ECESeniorDesign/greenhouse_envmgmt/hardware/sensor_module_1_0_render.png

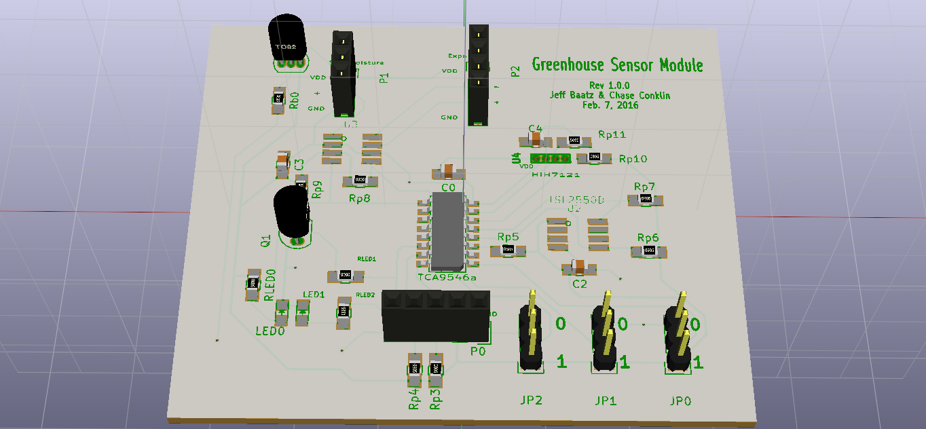
hardware/sensor_module_1_0_render.png
