ECESeniorDesign/greenhouse_envmgmt/hardware/sensor_module_render.png

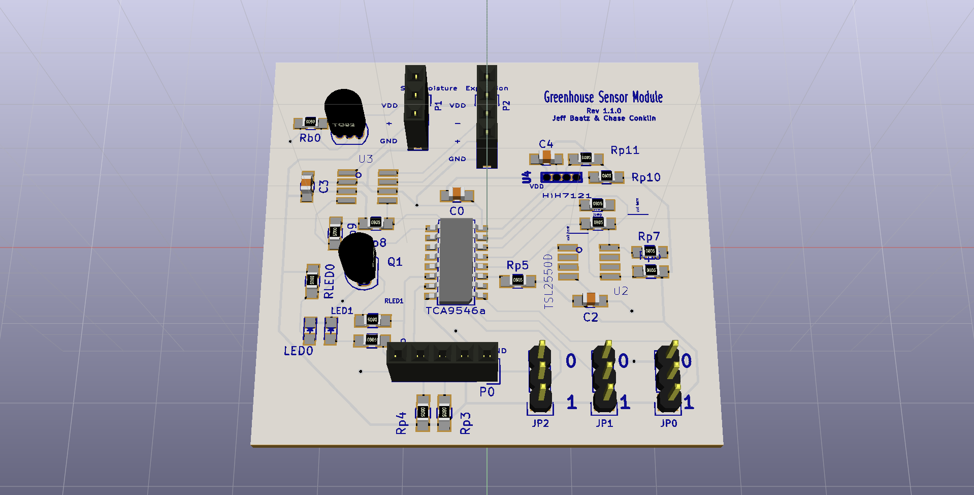
hardware/sensor_module_render.png
