ECESeniorDesign/greenhouse_envmgmt/README.rst

===========
Greenhouse Environment Manager
===========

This package contains models for interacting with the greenhouse sensor and control modules used for an automated tabletop greenhouse.

The README will be expanded as development continues, including detailed API usage.
