ECESeniorDesign/greenhouse_envmgmt/(list of files, cad)

Other CAD files:
hardware/model_GH.prt
