ECESeniorDesign/greenhouse_envmgmt/(threads)

Thread 1 (2015-12-11):

Create Development Sensor Modules

jeffrobots, 2015-12-11:
SMT sensor components should be mounted on a surfboard with easy to use pinouts for simple development.
This issue has been opened as a progress tracking mechanism.

jeffrobots, 2015-12-11:
Temperature and light sensors have been mounted and at least some of them have been verified to work. Closing issue.

Closed 2015-12-11.

Thread 2 (2015-12-11):

Test sensor modules for connectivity

jeffrobots, 2015-12-11:
- [x] Connect I2C modules to raspberry pi
- [x] Configure circuit according to datasheet.
        * http://pdf1.alldatasheet.com/datasheet-pdf/view/211808/STMICROELECTRONICS/STLM75M2E.html

- [x] Verify that the modules are working correctly by determining if they can be detected.
- [x] This should be repeated for all sensor modules after initial construction
   - [x] Temperature sensors
   - [x] Light sensors
   - [x] Humidity Sensors

Issue opened for progress tracking

jeffrobots, 2015-12-11:
The above steps have been verified for the temperature modules. The light sensor modules still need to be tested.

In order to test, the temperature modules were connected according to the datasheet listed above. Then, after enabling I2C on the raspberry pi, running sudo i2cdetect -y 1 pings all I2C devices and prints the addresses in the terminal.

Closed 2016-01-26.

Thread 3 (2015-12-13):

Light sensor modules do not support multiple address modes

jeffrobots, 2015-12-13:
The light sensors currently used in this project, the TSL2550D, are hard wired to a single address.

Why? No idea. Makes no sense.

Anyway, I need to figure out whether we can get by with just one lux sensor or if a method by which two can be used is possible. The final alternative would be going back to square one and getting a new lux sensor.

One possible solution here is to multiplex the SDA line. This would allow us to stretch out the single address by consuming one or two GPIO pins on the raspberry pi. This should be relatively easy. The only possible issue is I2C clock stretching that I can see, but it seems unlikely that this will actually cause an issue.

jeffrobots, 2015-12-13:
Possible target for I2C multiplexing:
http://www.digikey.com/product-detail/en/TCA9543ADR/296-42064-2-ND/5246239

Another solution could be using GPIO and a FET to physically power lux sensors down completely.

jeffrobots, 2015-12-19:
The I2C multiplexer is ordered and mounted. I will test as soon as I get a chance.

jeffrobots, 2015-12-20:
I may be holding off on this for a while. In attempting to solder on the breakout pins to the surfboard modules, I accidentally burned out one of the chips because my soldering iron just isn't small enough to avoid heating the board. Rather than risk burning out the other I2C multiplexer or an ADC, I may just wait until I have access to a better soldering iron.

jeffrobots, 2016-01-10:
Finally got the i2c multiplexer up and running. It turns out the issue that I was having was a lack of a pull-up to VCC on the active low reset line, causing the module to hold in a reset state and not respond to detects.

I can now begin using the i2c multiplexer to add in multiple light sensors and - if I decide to reorder them - humidity sensors as well.

jeffrobots, 2016-01-17:
Closing as per commit 13c06d7a230f20efa5b15ccbbee2ae22d221d495

Aside from a lack of pullup resisters that are required to make the system reliable, everything appears to be working well in breadboard test/verification.

Closed 2016-01-17.

Thread 4 (2015-12-19):

Humidity sensor needs SPI implementation

jeffrobots, 2015-12-19:
In a rush to get things ordered, I accidentally ordered a couple of HIH7131 sensors in the SPI variant instead of the I2C variant.

Since they're kind of expensive, I'm going to implement some code to acquire humidity data over SPI to make sure the sensors are going to fit the project requirement.

At some point, I will need to re-order the I2C modules so that I can use the I2C switching modules to get around the lack of switchable addresses in the HIH module.

[The datasheet can be found here.](http://sensing.honeywell.com/honeywell-sensing-humidicon-hih7000-series-product-sheet-009074-6-en.pdf)

jeffrobots, 2016-01-20:
This issue is now obsolete, as new I2C humidity sensors have been ordered.

Closed 2016-01-20.

Thread 5 (2015-12-19):

Fertilizer and Water Quality Levels

jeffrobots, 2015-12-19:
After doing some research into various methods for determining soil characteristics such as fertilizer and pH levels, it seems like it's going to be a lot easier to measure pH OR conductivity of our water reservoir, as this can be done using a probe in the water bucket whereas measuring soil quality is generally done by taking soil samples and diluting them with a known solution - it's not exactly practical at this point with our budget.

Note that I say OR above because getting a reliable sensor can be pretty expensive for either method.

#### pH
Measuring pH can be done with a glass probe and an interface circuit containing a gain stage, filtering, and potentially temperature compensation. BNC connected probes of varying quality can be had on Amazon for less than 30 dollars. This one seems like a no brainer: I even found a resource [here](http://www.eecs.ucf.edu/seniordesign/sp2014su2014/g09/documents/Group-9-Senior-Design-1-LeafAlone-Hydroponics.pdf) that may have some useful information on how to interface to one of these things. It looks like this project got a lot of it's info from Atlas Scientific, so I'll check that out to see what they have to offer.

#### Conductivity
A similar thing with conductivity can be done using a toroidal non-contact conductivity sensor. The
5000TC Toroidal Conductivity Sensor is an example of this. I'm having a hard time finding prices, but they look to be somewhere around $80-$100 dollars a piece. The downside here is that while conductivity might give us a guess as to nutrient levels (assuming we WANT to use water based fertilizers), it really just measures everything, so it's going to end up being dependent on whatever the water supply is. High chlorine levels would essentially look the same as high fertilizer levels, for example.

cconklin, 2015-12-19:
I wonder how the Flower Power was able to do it so easily?

jeffrobots, 2015-12-19:
In short... I don't think it was. I think what they did is use a cheap electrode to measure conductivity of the soil and then they just called it good. I have a feeling that the sensor on the Flower Power more or less amounted to a really crude, rough guess as to the soil condition.

Even having air pockets in the soil would throw off a simple electrode like that - the measurement would be highly dependent on water content.

cconklin, 2015-12-19:
I guess my feeling is a crude guess about the soil condition is better than an accurate understanding of the water condition (since the plants won't be in the reservoir water). Ignoring air pockets, would it be possible to combine soil moisture settings and conductivity to control for the effect of water? I would be happy to help with the constructing of a model for that once we get back from break.

Also, since pH is determined mostly by a chemical rather than electrical process, I say we go with conductivity.

jeffrobots, 2015-12-19:
I suppose it's possible to control for moisture effects. I've not been able to find any off the shelf soil conductivity sensors though. The DIY type stuff seems kind of ghetto and not very elegant, but perhaps we could come up with something.

What do you mean by chemical rather than electrical process? You can measure pH with an electrode probe. Here are a few references. [How-To guide using probes and a simple interface](http://www.allaboutcircuits.com/textbook/direct-current/chpt-9/ph-measurement/) | [Example of such a probe on Amazon](http://www.amazon.com/dp/B001EHJO64?psc=1)

Conversely, Here's an example of a conductivity meter [from Amazon](http://www.amazon.com/Sper-Scientific-Conductivity-Benchtop-Salinity/dp/B00BEZX6Z6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)

If we want to create an in-soil conductivity meter, we're probably going to have to make it ourselves.

cconklin, 2015-12-19:
I stand corrected.

cconklin, 2015-12-19:
Could we get something like [this](http://www.amazon.com/Luster-Leaf-1880-Rapitest-Electronic/dp/B000HHLJQA) and use an ADC to get our readings (since we aren't using many of our GPIO pins)?

jeffrobots, 2015-12-19:
That's certainly an interesting idea. My main concern there would be reverse engineering it and getting useful data from it. It's a slightly less elegant approach, but it could work. I find it really odd that just the probes themselves cost more than these all-in-one units. Perhaps I'm focusing too much on making the solution elegant and one-of-a-kind.

For the soil moisture level, [we can use these.](https://www.sparkfun.com/products/13322)

The ADC isn't an issue. I have three 4ch I2C ADCs mounted on some surfboards already. We've got plenty of power to go around there even without touching more GPIO.

jeffrobots, 2015-12-19:
According to the reviews on the types of meters, meters like this apparently corrode over time and become inaccurate. Something to think about I suppose. There probably isn't a way around that other than finding a way to clean them or just replacing them. If you think it's a good route forward, I can order a few to be here after break and we can hack a few of them apart. My plan was to try and figure out the soil moisture stuff over break along with how to solve the issue I've created with the humidity sensors in issue #4. Oops...

cconklin, 2015-12-20:
I think it is an interesting way to go forward. Let's do some research into what's out there for those, and try to have a list of candidates in the next week. If we like any of the options, we can order a couple and hack them apart.

jeffrobots, 2015-12-20:
If we want to do just pH, [we could use this one](http://amzn.com/B0000DI848) which is probably the cheapest bet. It's $25 for a 6 pack. It's a great blend of super cheap and replaceable and *allegedly* accurate readings.

For fertility, we could use the one you linked or [this one](http://amzn.com/B006JFY9ZW)

cconklin, 2015-12-20:
Let's get the pH meter you linked. While the one I found could measure more things, I don't think it could do it all at once, and developing the circuitry to switch between modes would be tricky.

jeffrobots, 2016-01-04:
I decided to hold off on ordering the stuff until I get back to school since I haven't been able to work with the interface modules that much. Fortunately, I just got a new soldering station with a hot air gun and SMT tips, so hopefully I can repair my earlier screwup and get everything else assembled.

jeffrobots, 2016-01-19:
After reading some literature and reviews, it seems that the lifetime of an anode/cathode type sensor like a pH sensor or soil moisture sensor can be extended significantly by keeping them powered off when you aren't using them. This would be easy to accomplish with a single MOSFET.

Closed 2016-02-03.

Thread 6 (2016-01-15):

Integrate sensors with webservice

jeffrobots, 2016-01-15:
[See issue 1 on Webservice Demo for more info](https://github.com/ECESeniorDesign/greenhouse-webservice-demo/issues/1)

Need to create an interface for linking webservice to the available sensor hardware.

My current idea is to create a model of a sensor cluster that contains information on current values and addresses for the various sensors.

cconklin, 2016-01-15:
As I see it, you intend to have a class that knows all about getting sensor information. That should work: all you would need to do would be to add a method of knowing which plant the sensors are for, and a `saveAllSensors` method that does the following:

```python
def saveAllSensors(self):
    # Assuming that you imported models
    plant = models.Plant.for_slot(self.plantId)
    # Save light data
    plant.sensor_data_points.light().build(sensor_value=self.lux).save()
    # More saving here...
```

jeffrobots, 2016-01-15:
The latest commit hopefully is doing what you're talking about. Aside from the greenhouse demo not having a space for a temperature record, this is hopefully ready to go into an implementation that can be used to demo.

I still need to tie in the I2C multiplexer and get the ADC/acidity/soil moisture stuff figured out. I also need to fix the humidity sensor situation. Aside from these glaring, very important issues, having this interface somewhat fleshed out is going to make tying these other modules in a bit more clearcut.

jeffrobots, 2016-01-15:
I forgot to add that the method for determining which sensor belongs to which plant is pretty much going to be to hardcode it in at the time of SensorCluster object instantiation. I could add a dictionary that would make it easier to read, but at the end of the day the addresses will still need to be hardcoded.

cconklin, 2016-01-15:
I just added temperature. You can look at the diff at ECESeniorDesign/greenhouse-webservice-demo@a101052 to see how to add more (if you need to).

cconklin, 2016-01-15:
Make sure that you also open a database connection and that you `import models` from the greenhouse webservice when you do it for real.

jeffrobots, 2016-01-23:
As per our test yesterday, I'm going to close this issue just to clear up the panel. However, since my code isn't currently interfacing outside of the tests to verify that it will work, you should be sure to get documentation up so that I can wrap all of that into the relevant scripts when the time comes to do so.

Closed 2016-01-23.

Thread 7 (2016-01-20):

Add support for UART

jeffrobots, 2016-01-20:
In order to use only one ADC module for the entire project, I have opted to use an extremely cost effective four channel ADC. Unfortunately, this threw my plan of having everything on I2C out the window - the I2C variant of the module is out of stock. So I ordered the UART one at a measly two dollars a chip. [The datasheet can be found here](http://www.silabs.com/Support%20Documents/TechnicalDocs/Si8900-1-2.pdf)

As such, support for UART in python is needed. I've been looking around at different packages. pySerial seems to be fairly promising [as shown here](https://electrosome.com/uart-raspberry-pi-python/)

It looks pretty straightforward to use once past the initial boot file configuration, so I'll get going on installing it and testing it in the next couple of days.

jeffrobots, 2016-01-23:
Obsolete.

Closed 2016-01-23.

Thread 8 (2016-01-21):

Design PCB for sensor modules

jeffrobots, 2016-01-21:
KiCad will be used to develop sensor module PCB files as soon as the prototype circuits are proven. The packages will use the smallest sensor packages possible. They should also include necessary pull-up resistors and bypass capacitors. The datasheets contain layout information (as well as connection information) and should be referenced often.

Required:
- [x] Proof the sensor module prototype in its entirety.
- [x] Move design to schematic and PCB Gerber file
- [x] Implement status LEDs and analog sensor power control
- [x] Design review of PCB layout

Recommended:
- [x] Move sensor prototype to a soldered perfboard and proof again
- [x] Order and test received PCBs

jeffrobots, 2016-01-24:
@cconklin In case you're interested, 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.

Even if you're not interested, I think I should go over the schematics with someone in the department before I send them off for fabrication. That's a little ways away though. I still need to get some new components in just to verify everything. I also need to figure out if any sort of interface/amplification will be needed on our pH and soil moisture meters.

cconklin, 2016-01-24:
Agreed. We can discuss it further with Derefinko on Monday.

jeffrobots, 2016-02-08:
The last required tasks before the PCB can be ordered are verifying the BJT soil sensor power control as well as looking into adding status LEDs where appropriate.

jeffrobots, 2016-02-10:
As of 6536d1a24c97237ee98df545fb8141bdaf6287d7 I have confirmed that using a transistor to power the soil sensor on and off will work.

I will be reworking the PCB files tomorrow to include this and a status LED.

jeffrobots, 2016-02-13:
@cconklin I just uploaded the gerbers to OSHPark. I'll figure out how to order through the department on monday.

If you want to see it, take a look here.

<a href="https://oshpark.com/shared_projects/Xo4KOmY4">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</a>

jeffrobots, 2016-03-03:
@cconklin

Everything works perfectly on the board except for, as you might be able to guess, the light sensor.

The status LED isn't working, and I thought it was an issue of the resistor size. After closer inspection, it seems possible that I actually wired it up backwards. They don't really have very visible markings for determining which way to put it and I wasn't really thinking straight when I was soldering it.

Are you free at all tomorrow afternoon in case I need a second pair of eyes on the light sensor? I've looked it over a bit and honestly have no idea what its problem is.

cconklin, 2016-03-03:
I probably won't be available.

jeffrobots, 2016-03-03:
After testing continuity on the pads of the light sensor, I discovered that the SMBus pads on the light sensor are indeed swapped. Luckily, @cconklin convinced me to put jumper pads so that I can switch them around if need be. I grabbed a few jumpers from the lab and will stick them on the board and cut the traces as soon as possible.

jeffrobots, 2016-03-03:
Closing as per today's testing.

Remaining issues regarding the sensor PCB will be design enhancements and should have their own issues.

Closed 2016-03-03.

Thread 10 (2016-01-23):

Automatically detect new sensor clusters

jeffrobots, 2016-01-23:
This is a low priority improvement that would make it much easier for a user to add new sensor clusters and to modify existing sensor cluster layouts.

A potential process for doing this would be to:
- Prompt the user to unplug all but one sensor module.
- Send out iterative commands to all of the detected I2C devices.
     - The commands will be unique such that - for example - only the temperature module will respond to a `detectTemperatureSensor()` command.
- Collect addresses, sensor type, and cluster ID for each sensor. There should be 4 addresses total.
     - Store this data in a CSV file.
- Prompt the user to unplug that sensor module and plug in another one.
- Repeat the processes, appending the new addressing information to the CSV.

When initializing the plant sensor structures in the python code, accessing this CSV will provide all of the necessary information. The process may also be able to warn the user of conflicting addresses.

Closed 2016-02-14.

Thread 11 (2016-01-23):

Implement Controls Interface

jeffrobots, 2016-01-23:
An interface by which python calls can be made to turn on the mist pump, grow lamps, and a ventilation fan is needed.

- [x] Set up GPIO package on raspberry pi
- [x] Create control model interface
- [x] Test/verify physical operation
    - This can be seen in the controltest.py script.
- [ ] Implement on-off logic based on an ideal and a current humidity/soil moisture
- [ ] Implement fan vent for a state where current humidity is too high
- [ ] Implement grow lamp on-off for when light levels are too low (should also be checking time of day)

jeffrobots, 2016-02-21:
The remaining tasks on this list are obsolete, as they will be handled in a separate python module.

Closing issue. Remaining controls tasks are related to updates to the controls API and hardware related tasks.

Closed 2016-02-21.

Thread 13 (2016-02-10):

Develop more simple API for sensors and Controls

jeffrobots, 2016-02-10:
- [x] Sensor modules
- [x] Controls

Each module should have a simple way to control all of its attributes. For the sensors, this means that updating sensors should be able to be done (but not required to be done) with one or two function calls.

For controls, this means that the user should be able to turn on and off individual control units on request with one or two function calls AND that the user should be able to specify a list of units that need to be turned on.

jeffrobots, 2016-02-21:
@cconklin

Could you look over the classes for the sensors and controls to see if the API is workable (or if you have suggestions on cleaning it up).

For sensors, you can mostly look at update_all_sensors(), update_instance_sensors(), and save_instance_sensors(). Note that update_all_sensors and update_instance_sensors() contain an optional argument for updating the soil moisture sensors instead since we may not want to constantly powering them up. Having the option to only update them on the hour - for example - will extend their lifetime significantly.

For controls, you can mostly look at control() and get_water_level().

These are really the only methods I would see you interacting with unless you want to do specific sensor updates or anything weird that I haven't thought of.

cconklin, 2016-02-21:
@jeffrobots

**Controls**

1. From an API standpoint, it doesn't make much sense to have `get_water_level` (a *sensor* method) to be present on a control interface. It looks like you put it here because the water tank sensor is connected to the control board.

2. How does the `bus` parameter change? I noticed in the control test file that you always set `bus = smbus.SMBus(1)`. Is this specific to the test you are running, or is this a universal constant. If the value is more of a constant (or isn't likely to vary / has a reasonable default), I would recommend making it part of the ControlCluster object (i.e. set to an instance variable during initialization) and having a default value.

**Sensors**

See point 2 above. Other than that, the API looks pretty good.

jeffrobots, 2016-02-21:
1) Good point. I originally put it there in case we wanted the pump operation to ask if it can turn on by sensing water level each time. This is now obsolete, since the pump can ping the database instead. My other reason being that it will be using a separate adc that sits on the controls.

2) The bus object is static, but it's global to the entire system. I hadn't thought to hide instances within sensor and control objects, but that would definitely clean up some of the methods so long as the smbus API supports that.

3) Ehh. I don't plan on using one now since we have the mist pump. It's more or less a feature that some users would want in the future, so I saw no reason to pull it out. I'm not that attached to it though.

cconklin, 2016-02-21:
Also, if a control cluster with ID 3 or 4 tries to turn off the pump, it looks like nothing will happen, since it won't send the update to the correct bank.

jeffrobots, 2016-02-21:
I'm not sure I follow your last point. The pump pin and bank are pulled from the controls class and are hard-coded to bank 0 pin 0. The pump requests list is dynamically sized and accessed by instance IDs. I'll take a look at it this afternoon to double check.

cconklin, 2016-02-21:
When you call `update`, it sends the mask for the bank to the bus. Since the pump bank is hardcoded to 0, when a control with ID 3 or 4 (bank 1) is updated, the pump will see no change. Is there something I am missing?

jeffrobots, 2016-02-21:
Ahh. Good catch. That's a simple patch. I'll put it in the API update to reflect your points this afternoon.

Closed 2016-02-22.

Thread 14 (2016-02-10):

Determine maximum cabling length for sensor nodes

jeffrobots, 2016-02-10:
The I2C Bus protocol allows for a maximum of 400pF of bus capacitance at 100kHz. Going above this - or even approaching it - will likely introduce communication errors. Luckily once the I2C data arrives at the sensor head, (the TCA9546a multiplexer) there is a rebroadcast of the signal and any additional capacitance is negligible. Furthermore, using small pull-up resistors decreases the capacitive time constant of the bus, yielding some additional wiggle room.

| Source of Capacitance | Capacitance Contribution | Maximum Contribution Allowed |
| ----------------------------- | -------------------------------- | -------------------------------------- |
| TCA9546 Mux               | 4.6 pF                               | 8 x 4.6pF (36.8 pF)                  |
| Ribbon Cable (13751-E)| 47.5pF/m or 26.7pF/m     | 7m * 47.5pf (332.5 pF)             |
| PN2222A (LED driver) |  25 pF max                         | 25 pF

If we want to go beyond this or not use ribbon cable (IE, use single core or threaded wire) we should be looking into cat5 or cat6 wire.

For the purpose of only using two sensors as in our prototype, it's going to be fairly negligable at 1m or so (which is about what we expect.)

Some more research and some lab tests should be done to verify that higher quality cable will not be needed for the initial prototype.

jeffrobots, 2016-04-12:
Issue is obsolete. Closing.

Closed 2016-04-12.

Thread 15 (2016-02-11):

Investigate light sensor failure

jeffrobots, 2016-02-11:
The light sensor TSL2550D is occasionally failing to update and the SMBus object is throwing an IOError exception.

It seems to be intermittent, and running the sensortest script repeatedly yields fairly mixed results.

So far, I haven't been able to successfully determine why this could be happening. I didn't start to see the issue until recently, so it's possible that it's caused by bus capacitance. Interestingly enough, this is the only module using the SMBus subprotocol. This could be a good thing to investigate, as the I2C multiplexer likely has settings that could compensate for any differences.

In the mean time, adding a retry method would be a quick but dangerous fix.

jeffrobots, 2016-02-11:
Immediately after I made this issue, I started removing things that I've added to the prototype in the last couple of days. The problem went away almost immediately after removing the BJT being used to control the I2C status LED. It looks as though the extra capacitance or load that this places on the bus is enough to completely kill the SMBus light sensor. Adding a larger resistor to the base of the BJT LED driver fixes the issue (I went from 1.8k and 2k and experienced no issues whatsoever), but I'm not very confident that the issue won't spring up later on.

Looking at the datasheet, the light sensor operates at a maximum frequency of 100kHz, which is the same bus speed that the Raspberry Pi defaults to. It could be that SMBus is more susceptable to bus capacitance for whatever reason, because I can't see any reason that the bus speed would be limited like that.

Closed 2016-02-20.

Thread 17 (2016-02-22):

Create Controls Prototype Circuitry

jeffrobots, 2016-02-22:
The control devices are currently modeled as simple LEDs in order to observe on/off capabilities. In order to control real devices, the LED/resistor circuitry needs to switch a BJT and thus turn on a relay. The controls circuitry has the following requirements.

Research areas:
- [x] Voltage/Power regulation
    - Needs 5V, 12V, and 24V.
    - The grow lamps will likely need 120AC.
    - Powering the raspberry pi through this same 5V would be ideal.
        - The best solution for this seems to be powering the pi through USB and having the pi supply the 5V to the rest of the circuitry that needs it (which is mostly ICs)
        - Make sure the analog sensors won't draw too much current in this case.
            - Using a supply that can give at least 700mA would likely be safe. RPi uses ~500mA
            - I've been using a laptop USB port, which theoretically only provides 500mA and have had no issues.

- [x] The IO pins need to be connected to the relays through a transistor.
    - Pin A0 will belong to the water pump.
    - Pin A1 will belong to the power switch for the analog sensors.
    - Other pin mappings can be found in the control model within ControlCluster
        - Ideally, the protoboard should be laid out so that these pins can be switched.

- [x] ADC for water tank level sensing
    - There needs to be an ADC mounted to the protoboard and hooked into the I2C bus.
        - Set address to 0x6c to avoid conflicts with SensorCluster ADCs
    - Use the 14SOIC ADC. It's overkill, but has a lot of address selection and could support other environment sensors later on.

Tasks:
- [x] Create schematic

- [x] Build breadboard prototype.
    - Can test with the fans and mini water pump if need be.
    - Make it at least somewhat re-configurable (using jumpers, perhaps)

- [ ] Order in lights

- [x] Connect actual control devices to the board

- [x] Mount on more permanent protoboard.

jeffrobots, 2016-02-23:
Created a prototype schematic shown below (using circuitlab)
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

My intention for the time being is to expose the inputs to each FET-Relay circuit to a jumper so that they can easily be swapped around by simply plugging them into the jumper in a different order.

The power supplies aren't really laid out at all on the schematic. This is because I haven't decided how I'll do it yet. I've been looking into buck converters that I could use to generate the 12V needed to power the fans that would be driven from the 24V pump supply. This same 24V supply will also provide the coil voltage needed to power the relays.

The lights are another story. They'll need to be powered off of 120AC. I can get away with one plug for all of the lights pretty easily provided I design their circuitry safe enough.

jeffrobots, 2016-02-24:
Per task 2:

The schematic above seems to work pretty well for making it easy to swap control devices around. It's just a matter of directing the VDD wire of the device to the proper voltage source for that device and connect the other to one of the relays. Other than that change, nothing is really needed to switch devices around. Also, since they're all relays, it doesn't really matter if say the pump is moved to another spot. This is the main benefit of a relay array - You can drive whatever you want on them and so long as the current doesn't exceed 5A, it will work.

jeffrobots, 2016-02-26:
Per research areas:

A buck converter will be used to generate the 12V needed to drive the fans and the 24V supply will be the same supply that's driving the pump - albeit with some circuit protection added in. The raspberry pi will be powered from a standard phone charger. The lights will be powered from a standard 110VAC outlet. This means that in total, three plugs will be used by the greenhouse. All power will be routed to a surge protector mounted to the greenhouse.

jeffrobots, 2016-03-22:
Creating a new issue to deal with more specific tasks regarding this issue.

The controls prototype functions correctly and has been mostly migrated to a perfboard solution. This perfboard solution needs to be finished and tested. It also needs to be fit into the control box.

Closed 2016-03-22.

Thread 18 (2016-02-24):

Can we instantiate multiple SMBus objects?

cconklin, 2016-02-24:
I'm working on the controls service on the web server, and I realized that I will need to have the controls establish a connection to the SMBus, which in production will occur at the same time as the sensor program (which also has a connection to the bus) is running. Will this cause a problem?

jeffrobots, 2016-02-25:
I ran a few tests to see how the SMBus class will handle multiple bus objects. It doesn't appear that you're going to run into any issues using multiple bus objects. I haven't tried anything with mutex/locks which I know you will be using, so I can't really make any guarantees there, but I suspect there's no issue either way.

Just make sure you always instantiate it as such:

```python
SensorCluster.bus = smbus.SMBus(1)
ControlCluster.bus = smbus.SMBus(1)
```

cconklin, 2016-02-25:
Thanks for looking into it.

jeffrobots, 2016-02-25:
@cconklin

I wanted to note that the SMBus objects have a close() and open() method. I've not used them a whole lot, but it appears that close() acts like a sort of pseudo-destroyer for a bus object. I say pseudo because while it does indeed disconnect the object from the I2C bus, it doesn't look like the open() method actually works right. Once you close it, reconnecting the object doesn't make it work again.

If this is functionality that you need, you'll need to play around with it to see if it will actually work properly.

Closed 2016-02-25.

Thread 19 (2016-02-26):

Making code available to web service

cconklin, 2016-02-26:
We are going to need a portable and simple way to ensure that the web service has access to the sensor and control code in this repository. I'm thinking that we could package this up and put it in PyPi so it is a simple "pip install" to get the necessary behavior anywhere.

Information about putting code on PyPi can be found [here](http://peterdowns.com/posts/first-time-with-pypi.html).

cconklin, 2016-02-26:
I can make the necessary changes, though it will result in a slight restructuring of the repository.

jeffrobots, 2016-02-26:
If you want to make the changes, I'm fine with that. I'm sure it would take me a day or two to get it figured out and ready for PyPi, since I'm not familiar with it. I'm assuming you will need to hide or remove the hardware aspect of the repo?

Either way, I'll look over the information you linked so that I at least know what's going on and can contribute.

jeffrobots, 2016-02-27:
I think I follow what needs to happen.

Basically, sensor_models and control_models need to put placed in their own directories, and then a new directory called "utils" would also need to be created to handle the utility functions that I've added. Each directory gets it's own `__init__.py`, the repo gets a new README, and then I tag for release. It doesn't sound too hard if you prefer I try and take care of it.

jeffrobots, 2016-02-27:
@cconklin

Greenhouse environment management (`greenhouse_envmgmt`) has been added to PyPi at release tag v1.0 with 146f08a082325edbb9c3235b110431809f9555db

After doing the pip install to test it out, I realized I'm going to need to clean up import dependencies. Think you could help out with that?

cconklin, 2016-02-27:
I can help with that.

cconklin, 2016-02-27:
It looks like your setup.py is bugged. There is a syntax error, and my pip can't find the python-smbus module.

```
Complete output from command python setup.py egg_info:
Traceback (most recent call last):
  File "<string>", line 1, in <module>
  File "/var/folders/jh/vszcshj577lcb234jny1fjkr0000gn/T/pip-wCAMGt-build/setup.py", line 10
     keywords = ['i2c', 'sensors', 'controls'],
            ^
SyntaxError: invalid syntax
```

Fixing the syntax error, I get:

```
Collecting python-smbus (from greenhouse-envmgmt==1.0)
  Could not find a version that satisfies the requirement python-smbus (from greenhouse-envmgmt==1.0) (from versions: )
No matching distribution found for python-smbus (from greenhouse-envmgmt==1.0)
```

jeffrobots, 2016-02-27:
I forgot to update setup.py with the one I used to register and upload with PyPi.

I removed install-requires completely in this version, but if you'd like to include it, the package is just smbus.

Sorry for the confusion.

cconklin, 2016-02-27:
Are you still having trouble with import dependencies?

jeffrobots, 2016-02-27:
The issue is more than - in order to use anything from the greenhouse-webservice, it needs to be added to the pack. It's more irritating than code-breaking. There are also probably packages being imported multiple times. It's something that can be cleaned up at a later date I believe.

jeffrobots, 2016-04-12:
Closing. The PyPi package will need to be updated once the sensors are calibrated, but is currently available.

Closed 2016-04-12.

Thread 21 (2016-03-03):

Revise PCB files to fix TSL2550 Footprint

jeffrobots, 2016-03-03:
The footprint and schematic file for the TSL2550D light sensor do not match up. This resulted in the pins for the clock and the data being swapped with one another. The PCB currently has pads for jumping the lines and cutting the old trace in order to switch them, but the kicad PCB files should be updated to have the error fixed by default.

jeffrobots, 2016-03-22:
Moved to low priority - Complete after other issues.

Thread 23 (2016-03-22):

Production controls circuitry and enclusure

jeffrobots, 2016-03-22:
The controls perfboards need to be finished and added to the control box.

Putting together the rest of the controls circuitry is dependent on the enclosure and cable management that will be used.

Tasks:
- [x] Determine cable routing and plug placement
- [x] Arrange and mount remaining controls hardware
- [x] Mount hardware and cabling inside enclosure with the raspberry pi

cconklin, 2016-03-22:
See this [micro-usb connector for the Pi](http://www.amazon.com/gp/product/B00OK6G036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). We will also need a 12V to 5V [buck converter](http://www.amazon.com/Nextrox®-Display-Supply-Converter-Module/dp/B00CBCGAL8/ref=pd_sim_23_2?ie=UTF8&dpID=410nEQxN-pL&dpSrc=sims&preST=_AC_UL160_SR160%2C160_&refRID=197WC55HT3SFKKTYTAV1).

jeffrobots, 2016-03-23:
As per recent work:

The controls circuitry has been mounted on a perfboard as the final solution. I have yet to verify that everything works after a few recent changes on the control board. The relay board appears to be working properly.

The next step is to mount everything inside the box enclosure. The placement of the plugs has been determined and we should be able to start routing the connection and cable paths in and out of the box soon.

A small pack of buck converter boards has also been ordered along with a 24V power supply. This will allow us to shrink the amount of external plugs down to one. The raspberry pi will be powered internally from a 5V buck converter.

jeffrobots, 2016-03-25:
@cconklin

I've just finished putting together the production controls circuitry and I've verified that it's working well.

Last Monday we talked about what software changes we would need to make in order to move to a 3-relay hardware solution and you mentioned me not needing to change anything on my side (aside from the pin mapping, I suppose).

Is this still the case? I was thinking of migrating all of the pin maps such that each control object is exposed to the same pin for the fan and the light respectively. They're already tied to the same pump, so no worries there.

Currently, a control module is exposed to 3 seperate pins (the valve is currently still included and needs removed). If your plan is to use one control module, then we won't need to change any structure and I'll just need to remap the pins to the correct ones to play with the current hardware. If you still wanted the control modules to be seperate, then I'll need to make more extensive changes.

For my reference, we will want the pump on the A1 relay, the fans in parallel on the A2 relay, and the lights in parallel on the A3 relay. The power toggle line for the soil sensors will be on A0 under the sensor model.

cconklin, 2016-03-25:
@jeffrobots

> Is this still the case?

Yes. I only have the web service interact with one control module (ID 1).

jeffrobots, 2016-04-12:
Work pertaining to this issue was completed at the end of last week on April 8th

Closed 2016-04-12.

Thread 24 (2016-03-30):

Install and mount environment hardware

jeffrobots, 2016-03-30:
The following components need to be mounted or installed to the greenhouse box.

- [x] Greenhouse sensor PCBs
    * These need to be coated in acetate first.
    * Three PCBs should be populated with one as a backup.
    * Custom cabling will need to be created. This should be measured.

- [x] Greenhouse controls box
    * See issue #23 for specifics.
    * Box should be mounted on the back or side of the greenhouse.

- [x] Pump/Fans/Lights
    * The pump will need a water reservoir to draw from, preferably mounted beside or behind the greenhouse.
        * The tank level sensor will need to run through the controls box and to the reservoir.
        * A 1" diameter tube is needed to house the level sensor.
    * Fans need to be bolted to the sides of the greenhouse.
    * Lights should be mounted on the top of the box and cabling should run so that the box can open

jeffrobots, 2016-03-30:
@cconklin

My goal is to try very, very hard to have all of this done by Friday of next week so that we can begin integration and test. I'm not sure how close I'll be to that deadline, but I may need a bit of help mounting some of the hardware to the greenhouse.

As soon as everything is installed, I'll want to get the web service/application running and integrated by the end of the following week, which is April 15th, so that we have almost two full weeks to debug. The sooner the better, but this is the latest these tasks should be done in my mind.

Let me know if you have anything blocking you currently in terms of getting the web service and application running on the Pi.

cconklin, 2016-03-30:
Currently nothing blocking me. I will try to get the web service running on the Pi by this Friday.

cconklin, 2016-04-01:
@jeffrobots

Web service installed on the pi and runs correctly. I've looked into getting it to start automatically, and that shouldn't be any real issue.

cconklin, 2016-04-03:
I have the autostart for the pi working. I can get it set up on yours sometime this week.

jeffrobots, 2016-04-03:
Sounds good.

Of course you'll get to see it during the status meeting tomorrow, but just to give you an update as to where I'm at in case you have any questions before the meeting.

* I've received the enclosure with all of the necessary holes routed into it. Standoffs were also made for the raspberry pi so that the RJ45 port isn't at the base of the enclosure, but rather in the middle.
* I've made a metric ton of custom cabling and I believe the internal enclosure cabling is complete.
    * This includes gluing the barrel jacks in place.
* I've sorted out the general arrangement of all of the components and they're currently taped in place.
    - [ ] I'd like to drill holes for standoffs for the remaining boards.
        * One board has its standoff holes covered because I'm just that good. This one may need to be glued down.
* I've calibrated the buck converters to 12V and 5V respectively. They appear to be pretty stable.
    - [ ] I still need to actually power the raspberry pi via the cable I made to make sure it works. I've been putting it off.
* External cabling:
    * I've made a parallel cable to neatly hook up the fans. I may do this with the sensors as well.
    - [ ] I still need to hack together a cable for the LED lights so that they can use the barrel jack on the back of the box.
    - [ ] I still actually need to make the cable to connect to the sensors. I will do this after we decide how to mount the sensors.
* I've populated a second greenhouse sensor and verified that it works. I will do the third once everything else is together.

I'm in the lab right now for the next hour or so. I will finish putting together the cables that we need to connect to the controller box. If I have time after doing that, I'll tape everything into its final position in the box and try to fire it up using the 24V supply.

jeffrobots, 2016-04-03:
I've tested the raspberry pi in the enclosure running from the 5V buck converter. Everything works as intended. I also ran the controltest script and successfully toggled the correct relays. I'm not really worried about the sensors; I expect them to work with no issues.

The last remaining hardware tasks include:

- [ ] Mounting the water level sensor inside a PVC tube and running cable to the box.
    * We also need a tank.

- [ ] Permanently mounting all of the hardware inside the box with standoffs/glue/etc.

- [ ] Calibrating sensors

- [ ] Finishing up cabling.
    * This is mostly done, but I'll probably need to change a few things once it's all mounted and I see where all of the components need to go.

cconklin, 2016-04-03:
The requirements specify a 5 gallon tank.

jeffrobots, 2016-04-12:
Issue is no longer relevant. Though some things still technically need to be mounted, this does not need an issue to keep organized any longer.

Closed 2016-04-12.

Thread 25 (2016-04-12):

Calibrate Sensors

jeffrobots, 2016-04-12:
The following sensors need to be calibrated to ensure that they correspond to correct values when compared with those from known-working sensors.

- [ ] Light
- [ ] Soil moisture (may be difficult to quantitatively calibrate)
- [ ] Water level (for the pump reservoir)
- [ ] Temperature
- [ ] Humidity (may not be possible to calibrate)

Thread 27 (2016-04-23):

IO coherence issue across reboots

jeffrobots, 2016-04-23:
When the Raspberry Pi is rebooted, the contents of the IO register in the MCP23107 IO expander do not clear. Once the webservice scripts start up, they believe that the IO module is completely turned off, even though they are still on.

This also causes the lights to appear to turn off for no reason as the ControlClusters knowledge of what devices should be on is not synchronized with the web-service.
