ECESeniorDesign/greenhouse_envmgmt/hardware/controls.pdf

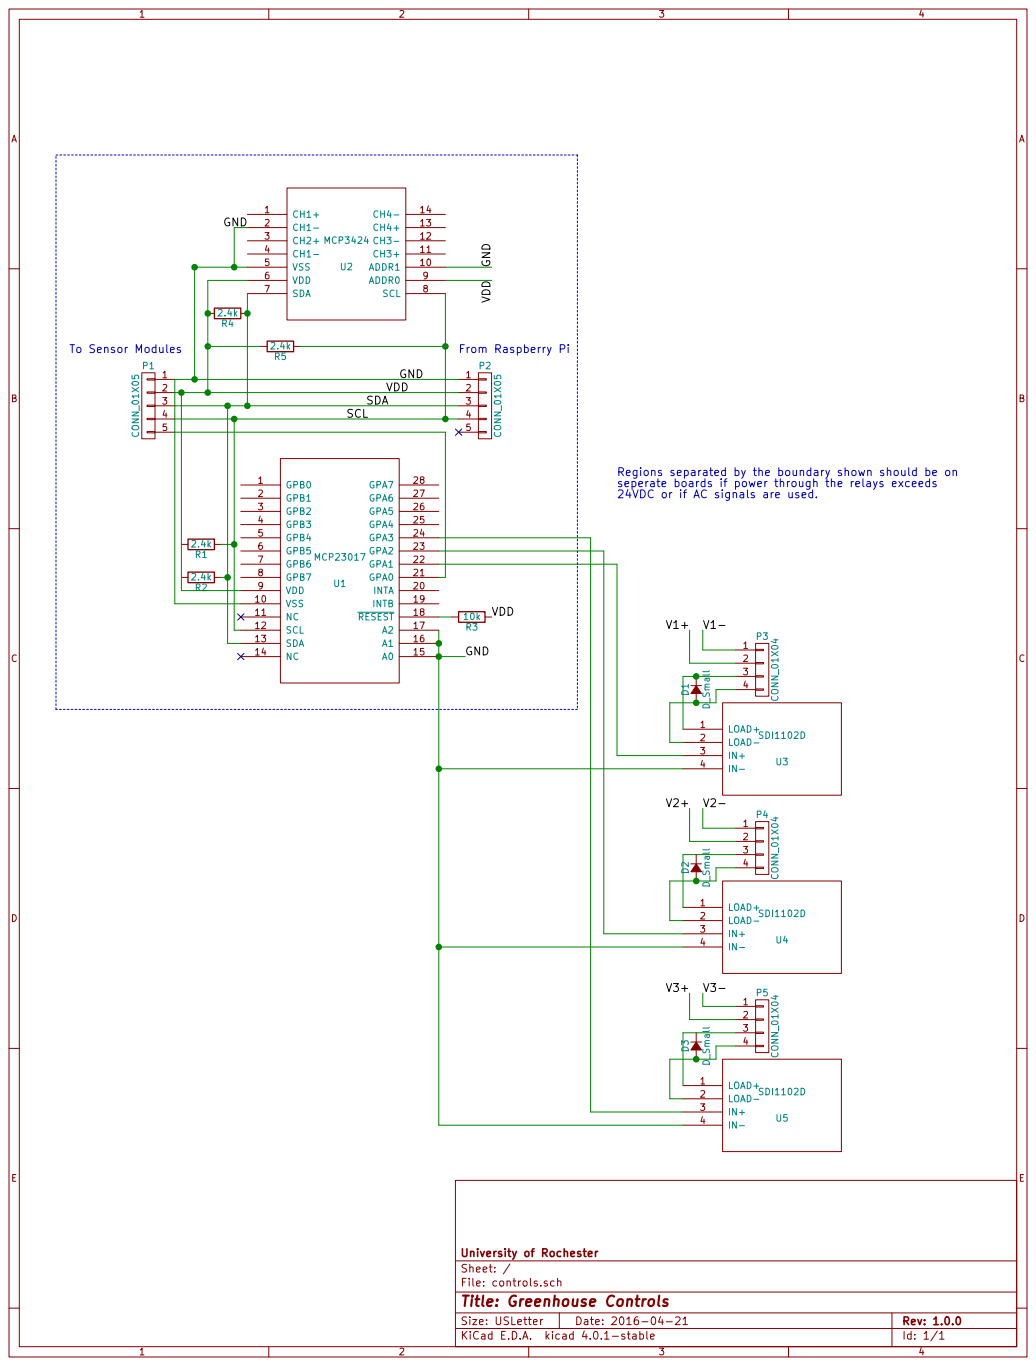
[picture p3: page 1]

5 P1 CONN_01X05 2 | | VDD | 5 P2 CONN_01X05 1 2

3 | | SDA | 3
4 | SCL | | 4

seperate boards if power through the relays exceeds
24VDC or if AC signals are used.

File: controls.sch Sheet: / University of Rochester

Id: 1/1 Title: Greenhouse Controls
