ECESeniorDesign/greenhouse_envmgmt/greenhouse_envmgmt/control.py

#!/usr/bin/python
from i2c_utility import IO_expander_output, get_ADC_value, get_IO_reg
from operator import itemgetter
from math import pi
from time import sleep


class IterList(type):
    """ Metaclass for iterating over control objects in a _list
    """
    def __iter__(cls):
        return iter(cls._list)


class ControlCluster(object):
    """ This class serves as a control module for each plant's
            fan, light, and pump valve.

        Upon instantiation, the class will use it's ID in order to
            generate a GPIO mapping corresponding to the pins on the MCP
            IO expander.

        Currently, only four plant control sets can be supported. IDs
            must be greater than 1 and no higher than 4.

        Usage: plant1Control = ControlCluster(1)
            This will create the first plant control unit.

            Turning on control units individually:
                plant1Control.manage("fan", "on")
                plant1Control.manage("light", "off")
                plant1Control.update()

    """
    __metaclass__ = IterList
    _list = []
    GPIOdict = []
    pump_pin = 1  # Pin A1 is assigned to the pump
    pump_bank = 0
    current_volume = 0
    bus = None

    @classmethod
    def compile_instance_masks(cls):
        """ Compiles instance masks into a master mask that is usable by
                the IO expander. Also determines whether or not the pump
                should be on. 
            Method is generalized to support multiple IO expanders
                for possible future expansion.
        """
        # Compute required # of IO expanders needed, clear mask variable.
        number_IO_expanders = ((len(cls._list) - 1) / 4) + 1
        cls.master_mask = [0, 0] * number_IO_expanders

        for ctrlobj in cls:
            # Or masks together bank-by-banl
            cls.master_mask[ctrlobj.bank] |= ctrlobj.mask
            # Handle the pump request seperately
            if ctrlobj.pump_request == 1:
                cls.master_mask[cls.pump_bank] |= 1 << cls.pump_pin

    def update(self):
        """ This method exposes a more simple interface to the IO module
        Regardless of what the control instance contains, this method
        will transmit the queued IO commands to the IO expander

        Usage: plant1Control.update(bus)
        """
        ControlCluster.compile_instance_masks()

        IO_expander_output(
            ControlCluster.bus, self.IOexpander,
            self.bank,
            ControlCluster.master_mask[self.bank])

        if self.bank != ControlCluster.pump_bank:
            IO_expander_output(
                ControlCluster.bus, self.IOexpander,
                ControlCluster.pump_bank,
                ControlCluster.master_mask[ControlCluster.pump_bank])

    def form_GPIO_map(self):
        """ This method creates a dictionary to map plant IDs to
        GPIO pins are associated in triples.
        Each ID gets a light, a fan, and a mist nozzle.
        """
        # Compute bank/pins/IOexpander address based on ID
        if self.ID == 1:
            self.IOexpander = 0x20
            self.bank = 0
            self.fan = 2
            self.light = 3
            self.valve = 4
        elif self.ID == 2:
            self.IOexpander = 0x20
            self.bank = 0
            self.fan = 5
            self.light = 6
            self.valve = 7
        elif self.ID == 3:
            self.IOexpander = 0x20
            self.bank = 1
            self.fan = 0
            self.light = 1
            self.valve = 2
        elif self.ID == 4:
            self.IOexpander = 0x20
            self.bank = 1
            self.fan = 3
            self.light = 5
            self.valve = 6
        else:
            raise InvalidIOMap(
                "Mapping not available for ID: " + str(self.ID))

        # Check to make sure reserved pins are not requested
        if (self.bank == 0) and (min(self.fan, self.light, self.valve) < 2):
            raise InvalidIOMap(
                "Pins A0 and A1 are reserved for other functions")

        self.GPIO_dict = [{'ID': self.ID, 'bank': self.bank,
                           'fan': self.fan, 'valve': self.valve, 'light': self.light}]

        # Append dictionary to class and resort dictionary by ID # if needed
        ControlCluster.GPIOdict.append(self.GPIO_dict)
        # ControlCluster.GPIOdict=sorted(
        #    ControlCluster.GPIOdict, key=itemgetter('ID'))

    def manage_light(self, operation):
        """ Turns on the lights depending on the operation command
        Usage:
            manage_lights("on")
        """
        return self.manage("light", operation)

    def manage_fan(self, operation):
        """ Usage:
                manageFans("on") # Turn on the fan for plant 1
        """
        return self.manage("fan", operation)

    def manage_valve(self, operation):
        """Manages turning on the mist pump based on water data from the plant.
        We will need to aggregate the total amount of water that the plant
        receives so that we can keep track of what it's receiving daily.

        This function will need to select a nozzle to open
        before turning on the mist pump.
        """
        return self.manage("valve", operation)

    def manage_pump(self, operation):
        """
        Updates control module knowledge of pump requests.
        If any sensor module requests water, the pump will turn on.

        """
        if operation == "on":
            self.controls["pump"] = "on"
        elif operation == "off":
            self.controls["pump"] = "off"

        return True

    def manage(self, control, operation):
        if control not in {"light", "valve", "fan", "pump"}:
            raise IOExpanderFailure(
                "Invalid controller")
        if operation not in ["on", "off"]:
            raise IOExpanderFailure(
                "Invalid operation passed to {} controller".format(control))
        if control == "pump":
            return self.manage_pump(operation)
        else:
            self.controls[control] = operation
            return True

    def control(self, on=[], off=[]):
        """
        This method serves as the primary interaction point
            to the controls interface.
        - The 'on' and 'off' arguments can either be a list or a single string.
            This allows for both individual device control and batch controls.

        Note:
            Both the onlist and offlist are optional. 
            If only one item is being managed, it can be passed as a string.

        Usage:
            - Turning off all devices:
                ctrlobj.control(off="all")
            - Turning on all devices:
                ctrlobj.control(on="all")

            - Turning on the light and fan ONLY (for example)
                ctrlobj.control(on=["light", "fan"])

            - Turning on the light and turning off the fan (for example)
                ctrolobj.control(on="light", off="fan")

        """
        controls = {"light", "valve", "fan", "pump"}

        def cast_arg(arg):
            if type(arg) is str:
                if arg == "all":
                    return controls
                else:
                    return {arg} & controls
            else:
                return set(arg) & controls

        # User has requested individual controls.
        for item in cast_arg(on):
            self.manage(item, "on")
        for item in cast_arg(off):
            self.manage(item, "off")
        sleep(.01) # Force delay to throttle requests
        return self.update()

    def restore_state(self):
        """ Method should be called on obj. initialization
            When called, the method will attempt to restore 
            IO expander and RPi coherence and restore
            local knowledge across a possible power failure 
        """
        current_mask = get_IO_reg(ControlCluster.bus,
                                 self.IOexpander, 
                                 self.bank)
        if current_mask & (1 << ControlCluster.pump_pin):
            self.manage_pump("on")
        if current_mask & (1 << self.fan):
            self.manage_fan("on")
        if current_mask & (1 << self.light):
            self.manage_fan("on")



    @property
    def mask(self):

        def construct_mask(mask, control):
            if self.controls[control] == "on":
                return mask | 1 << self.GPIO_dict[0][control]
            else:
                return mask

        # probably should hold a constant of these somewhere
        controls = ["fan", "light", "valve"]

        mask = reduce(construct_mask, controls, 0x0)

        # handle pump separately
        if self.controls["pump"] == "on":
            self.pump_request = 1
        else:
            self.pump_request = 0

        return mask

    def __init__(self, ID):
        self.ID = ID
        self.form_GPIO_map()
        self.controls = {"light": "off",
                         "valve": "off", "fan": "off", "pump": "off"}
        self.restore_state()
        self._list.append(self)


class IOExpanderFailure(Exception):
    pass


class InvalidIOMap(Exception):
    pass
