ECESeniorDesign/greenhouse_envmgmt/(commit log)

2015-12-13 Functioning demo script to read temperature and lux
    Script prints out current temperature and accesses the light sensors two
    photodiodes to collect data, calculating the LUX based on this data.
    See issue #2
2016-01-15 #6: Initial sensor cluster models added
    Initial model layout for a sensor cluster that should be easier to
    manage and expand on than the previous script `i2c_read_nodes.py`
2016-01-15 #6: Added method to save values
    Also added some base functionality to test how exception handling could
    work during the sensor update stage. This should be ready to go into an
    implementation at this point.
2016-01-16 #3 Added I2C Multiplexer switching to sensor models
    Added a utility to switch between I2C MUX channels and implemented the
    utility into the sensor models.
2016-01-17 #3, #6: Verified I2C Bus Multiplexor. Verified sensor cluster base functions
    As per issue 3, the I2C multiplexer appears to be responding to
    switching commands and successfully routing I2C commands through to the
    correct module.
    As per issue 6, the sensor cluster class and its respective methods
    appear to be working as intended. Creating individual SensorCluster
    modules with all of the needed information to carry out data acquisition
    provides a clean and elegant way to interface to the web interface, as a
    caller would be able to run `updateAllSensors()` followed by
    `saveAllSensors()`
    I have yet to test the actual interface between a database, as I need to
    put in a bit more work to understa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
    [i2c_utility.py, sensortest.py]
2016-01-20 #2 Added support for humidity sensors
    Added functionality supporting the I2C humidity sensor modules in
    preparation for when they arrive later this week.
2016-01-21 Fixed formatting and saveAllSensors function
    [i2c_utility.py]
2016-01-21 #8 Added sensor hardware datasheets
    Datasheets contain information on connections, layout, and suggested
    practices that should be noted in PCB and prototyping design.
2016-01-24 #8 Initial prototype of PCB Added
    The files added as part of this commit are all associated with the first
    prototype of the PCB. I'll be removing a lot of these files later on as
    I figure out exactly what files are needed in order for someone else to
    view and generate the files needed to print their own board.
    A 3D rendering of the board has also been added.
    [sensor_module.kicad_pcb, sensor_module.sch]
2016-01-24 #8 Minor tweak to circuit and rendering options.
2016-01-26 Close #2: Implemented Humidity Sensor Module
    The humidity sensor is working properly and currently measuring ambient
    humidity.
    It has a feature that will measure temperature as well. I intend to use
    this feature to verify that the device is working properly and if it's
    accurate enough, I may remove the dedicated temperature sensor.
    [sensor_module.sch]
2016-01-26 #11: Added Development Controls Interface
    As per previous commit, I noticed a slight mistake with the last file.
    `controls.py` serves as a basic brainstorming controls interface that
    will be expanded and modified a lot in the next couple of days.
    Working on this script helped me to realize that using an IO expander is
    probably the way to go; The GPIO header was starting to get pretty
    crowded when I was going through all of the different control modules.
2016-01-28 Restructured Sensor Model
    This new sensor model structure hides each sensor cluster behind a
    single node head (in this case, the node head is an I2C multiplexer).
    This eliminates the need for individual sensor addresses and further
    generalizes the models. This also abstracts more hardware away from the
    python script and thus will make it easier for a user to add sensors.
    [sensor_module.sch]
2016-01-30 #11: Created control model, added support for IO expander
    The control model contained in this commit should make interfacing to
    the control modules a little bit easier by abstracting a lot of low
    level register manipulation into the model.
    Each control cluster will need to be instantiated with an ID. It will
    also receive a SensorCluster object (of the same ID) and a list of ideal
    values for the given plant.
    Methods within the control model exist that compare these ideal and
    sensed values and then build a mask that can then be stored into the IO
    expander once all of the control unit pins have been configured.
    Utilities have also been added to support the MCP IO expander. These can
    be seen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
2016-01-31 #11 Tested Control Models
    controltest.py contains a short script that creates a couple of control
    objects and runs through the methods and accesses various fields that
    would be used in control-type situations
    [controltest.py, i2c_utility.py, sensortest.py]
2016-01-31 #11 Verified physical functionality - added test cases
    Additional test cases have been added to the controltest.py script in
    order to test and verify physical function through a series of LEDs
    acting as a proxy for the control modules later on.
    i2c_utility.py was modified slightly to fix an error with setting the
    pin IO direction.
    [controltest.py, i2c_utility.py]
2016-02-03 Close #5: Added soil moisture sensing
    Soil moisture sensors now have full support. I'm closing this issue as
    we may be removing pH sensing from the project for now, though space
    will exist on the ADC to measure an additional parameter.
    As of this update, the plant sensor prototype is functionally complete.
    Calibration may be needed to dial in the soil moisture sensor when it's
    used in soil, but this will be a simple mapping function if it is even
    required. The sensor currently outputs 0 for dry air and 1 when
    submersed in water.
    [controltest.py, i2c_utility.py, sensortest.py]
2016-02-04 #11 Added pump water level sensor support
    Added a method to the ControlCluster to track the water level of the
    water tank on request. This method is currently untested, but will be
    tested once I have had a chance to put the hardware together.
2016-02-06 #8 Revised PCB to reflect new sensor module structure
    The PCB design files included with this commit are tentatively ready for
    a design review.
    In order to view the files on another computer, the .mod and .lib files
    are needed. I will attempt to package these in a more convenient way at
    a later point.
    [sensor_module.kicad_pcb, sensor_module.sch, sensor_module_1_0.kicad_pcb, sensor_module_1_0.sch]
2016-02-07 #8 Added gerbers and rendering of revised PCB
    The PCB has been shrunk down by about 4 square inches and labelling to
    make it more user friendly has been added where appropriate.
    I will also be removing any kicad files in favor of keeping only gerbers
    and renderings available.
2016-02-07 #8 Added rendering
    As per last commit, I've moved the rendering out of the kicad folder.
2016-02-08 Removed Extra KiCad Project Files
    Only Gerber files need be made available for now. Other project files
    can be provided on request.
    [sensor_module_1_0.kicad_pcb, sensor_module_1_0.sch]
2016-02-10 #13 Reworked Sensor Module API
    The sensor module now exposes a fairly simple set of methods that allow
    the user to update all sensors for all modules with one function call,
    update individual sensors for a single plant, or update all sensors for
    a single plant.
    Saving can be done either on a batch update or on request.
    [controltest.py, i2c_utility.py, sensortest.py]
2016-02-10 #13 Reworked Sensor API
    This is a re-do of a previous commit.
    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
    [controltest.py, i2c_utility.py, sensortest.py]
2016-02-11 #8 Added revised analog sensor control and status LEDs
    The status LED and analog power interface circuit have been tested in
    prototype and added to the PCB design.
    In addition to these changes, this commit also has removed the STLM75a
    temperature sensor in favor of using just the temperature readout of the
    HIH7121 humidity/temp module.
2016-02-11 Added support for robustness testing and data logging
    Modifications to the sensortest script as well as the sensor models now
    support extended robustness testing and data logging.
    To illustrate, I have attached a log that ran 200 consecutive sensor
    update and save commands.
2016-02-11 Added support for robustness testing and data logging
    Reference commit 9f34c8dc067e84ed4f21012804cf462e6066639a
    I somehow forgot to include the correct files in the original commit.
    This adds support for robustness tests and data logging and includes one
    200 point sample test.
    [sensortest.py]
2016-02-14 #8 Uploaded production version of module
    The gerber files in this commit as well as the 3d render match what was
    uploaded to Osh Park.
2016-02-14 Close #10. Added support for acquiring active sensors
    The added I2C Utility function exposes a means by which all active I2C
    device addresses are placed into a list. The method includes an option
    to only return sensors as well.
    Sensor module objects can then be created by iterating through this list
    of I2C Sensor module addresses.
2016-02-20 Close #15: Fixed Light Sensor Errors and Readout
    Fixed an issue where the TSL2550D light sensor occasionally refused to
    respond to commands intermittently. This specific issue was tied to the
    lack of a forced wait time for onboard ADC conversion. The downside of
    this fix is that - in order to correctly acquire results - it takes
    nearly a second to convert ADC results. A possible solution to this
    method would be to use the extended mode, which reduces total wait time
    to 160 ms.
    The second issue with the light sensor was tied to incorrectly
    interpreting the conversion algorithm in the datasheet. This fix seems
    to have corrected the readout of the device.
    [sensortest.py]
2016-02-21 #13 Added extended lux operation.
    User can now select extended (which is faster) or standard (which has
    800ms delay) modes of operation on the TSL2550D lux sensor.
    Sensor code and the API has been cleaned up slightly.
2016-02-21 #13 Improved pump support and API
    This commit has two main features:
    1) The pump is now governed by a list that each control object is
    capable of accessing through the parent class. If any of the components
    of this list are int(1), the pump will turn on. I may later add support
    for different options here, but this would be easiest to interface with
    valves if we intend to keep support for them.
    2) The API for the control module has been expanded in order to make it
    easier to interface with as per issue #13. This largely comes in the
    form of the method control(). This method accepts a variety of inputs in
    order to provide the user a few different ways to update the controls.
    [controltest.py]
2016-02-21 Created master mask so that the controls class has knowledge of each object's requests. Controls objects now make pump requests and these requests are compiled to the master mask later on. The change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
    The method to update the tank water level has also been removed from the control model and will be readded as part of the sensor model later on.
2016-02-21 Fixed bug causing pump to lock in on state
    The existence of pump_operation was causing a self-locking loop, so that
    once the pump_operation bit was set high, it was difficult to get the
    pump to turn off. This has been completely removed from the control
    model.
2016-02-22 Close #13: Moved water level meter to sensor class.
    This commit wraps up the design tweaks/refactoring of the sensor and
    controls API. Future changes will come from debugging and feature
    additions such as issue #9.
2016-02-23 Migrated analog sensor power control to SensorCluster class
    Changes have been tested and varified. A method was added to the I2C utilities to allow a module to read the contents of the IO modules two IO banks. This prevents any conflicts where the SensorCluster class would potentially overwrite ControlCluster IO requests.
    [i2c_utility.py]
2016-02-23 Verified bus abstraction functionality.
    Everything worked great aside from a typo. I've also manually resolved the changes in a recent commit to the master that I would normally have waited on, but it was actually a fatal error and was preventing me from running the test scripts. The additions pertain to finishing the migration of the analog sensor power control code into the SensorCluster class.
    [i2c_utility.py]
2016-02-23 Fixed horrible errors with last commit.
    Strangely enough, none of the diff tags showed up on my windows host. Odd.
    [i2c_utility.py]
2016-02-25 Added CAD files for greenhouse structure
    These files serve as a preliminary sketch as to the dimensions and features of the greenhouse. The light fixtures have no means of mounting in these files, as a support beam can be added at a later point and is not integral to the cutting that will be done in the workshop.
    [model_GH.prt]
2016-02-25 Fixed ADC Value Retrieval
    Corrected error in ratiometric scaling where the result was off by a factor of two. The problem was due to failing to recognize that since it's a differential ADC, one bit of the resolution is used to provide the sign of the value - essentially halving the resolution.
    [i2c_utility.py]
2016-03-18 added sensor method to get sensor data and removed dependence on the greenhouse
2016-03-22 #19 Edited sensor tests to work with new interface
2016-03-25 #23 Remapped IO pins to work with hardware.
    The IO pins have been remapped to account for the fact that only 1
    control object is going to be used per greenhouse box.
    The test script has also been updated to work with the new sense and
    control models.
    Along with this commit, I have also verified that the production control
    circuitry is working properly and is ready to be mounted inside the
    enclosure.
2016-03-29 Close #9. Fixed ADC and verified that sensor is working.
    The sensor appears to be working and the pi is able to get the water
    level within about a quarter of a centimeter.
    We will need to add the water level sensor to a tube of some sort in
    order to keep it rigid and exposed to water.
    The ADC changes should also be reflected in the soil moisture sensor.
    This change can be made during calibration.
    [i2c_utility.py, sense.py]
2016-04-11 Fixed issue with previous commit
    A couple of necessary changes was left out of the last commit by
    mistake.
    The analog power pin has been moved (as it was previously tied to the
    control for the pump) and the method `import_i2c_addr()` has been
    changed to return sensor addresses by default.
    [i2c_utility.py, sense.py]
2016-04-12 #25: Calibrated reservoir sensor
    Temperature has been changed to store in F.
    Some changes to the way out-of-bounds soil moisture values effect the
    system were also made.
2016-04-12 #25 Re-calibrated depth sensor and scaled soil moisture sensor
    Offset for depth sensor was too large and has been decreased to more
    accurately reflect the values. It appears that the small measurements
    threw off the calculated slope (or the slight nonlinearity meant that it
    went off target. Additionally, the size of the container was too large
    in the file and has been lowered.
    The soil moisture now represents itself as a value from 0 (being dry
    air) to about 1 when submerged in water. Values in between will
    represent a percentage of moisture content. It appears that values will
    be around the 30-70% mark for adequate soil conditions for most plants.
    [sensortest.py]
2016-04-12 #25: Recalibrated sensors (see 58bc92b)
    This commit includes a file that was supposed to be part of the 58bc92b
    commit.
2016-04-14 Fixed sensor automatic addressing
    Extraneous imports have also been removed from the sensortest script.
    [sense.py, sensortest.py]
2016-04-14 Corrected initalization error and test scripts
    [sense.py, sensortest.py]
2016-04-18 #25 Corrected soil moisture scaling
    [sense.py, sensortest.py]
2016-04-18 Added delay to throttle control requests
    A forced sleep will prevent requests from the webservice from being
    ignored by the controls.
    [control.py]
2016-04-19 Added light ratio to help determine ambient light quality
    light_ratio will be used to satisfy issue 26 in the
    greenhouse-webservice. Its purpose is to provide data by which a user
    can be notified if the light quality in the room is inadequate
    throughout an entire day (implying that the grow lights would need to be
    on at all times)
    [sense.py]
2016-04-22 Added controls schematics
    [controls.kicad_pcb, controls.sch]
2016-04-23 #27 Added ability to resynchronize a control module after reboot
    The added method, `restore_state()` will query the IO expander in order
    to retrieve information about what devices were on at the time of the
    reboot.
    [control.py]
